mniedzielski1/synscan-esp/enclosure/obudowa_lid.stl

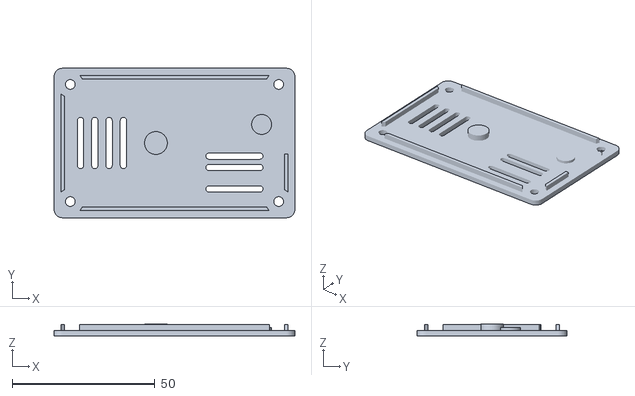
[picture p1: CAD file, 2026-10-15]
enclosure/obudowa_lid.stl
84.4 x 52.4 x 4.30
