mniedzielski1/synscan-esp/enclosure/obudowa_base.stl

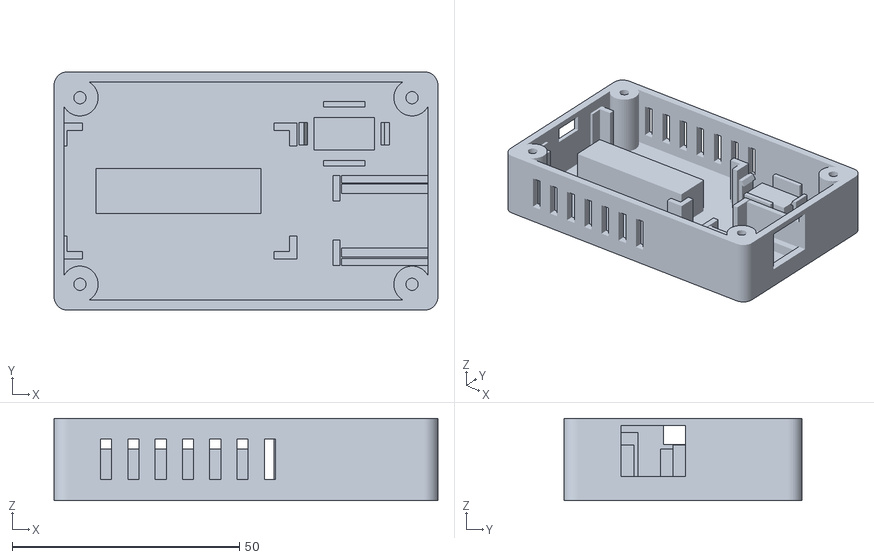
[picture p2: CAD file, 2026-10-15]
enclosure/obudowa_base.stl
84.4 x 52.4 x 18.1
